arkorobotics/DEMI_Buffer/3D Printables/connector_housing_extended v2.stl

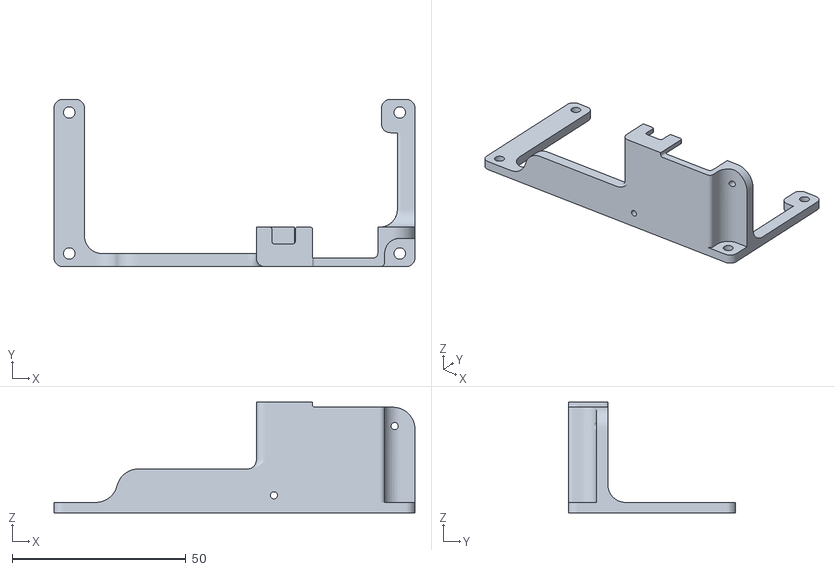
[picture p1: CAD file, 2023-05-14]
3D Printables/connector_housing_extended v2.stl
104.0 x 48.3 x 32.0
