arkorobotics/DEMI_Buffer/DEMI_Buffer.pdf

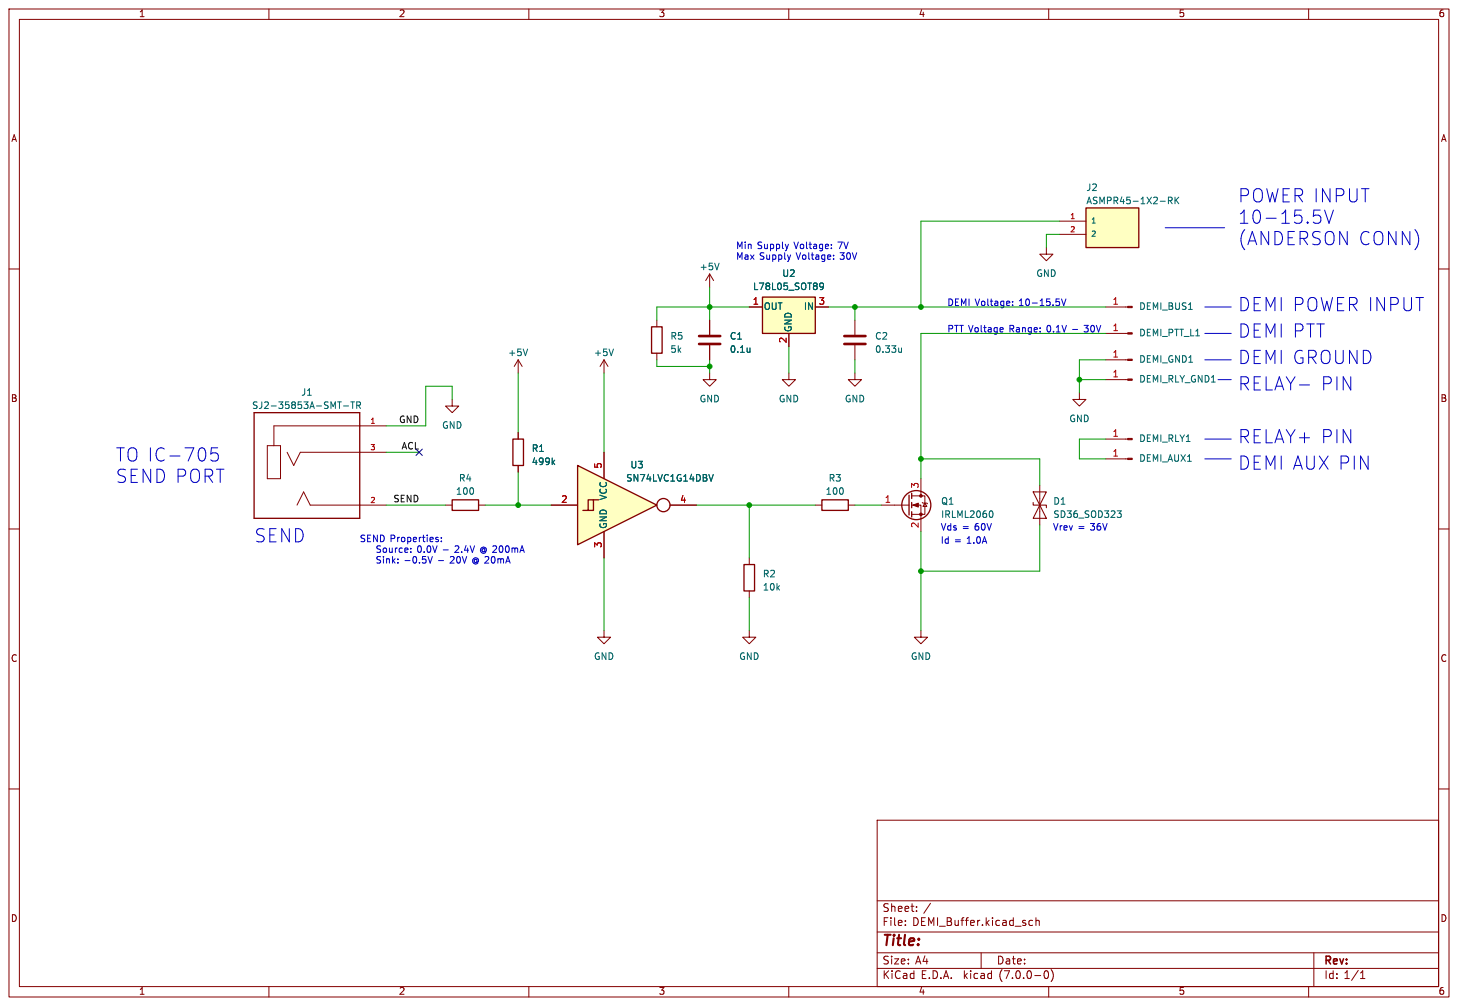
[picture p2: page 1]

Id: 1/1 Title: File: DEMI_Buffer.kicad_sch Sheet: /
