arkorobotics/DEMI_Buffer/DEMI_Buffer.kicad_pcb

## KiCad design DEMI_Buffer.kicad_pcb (2023-05-14)

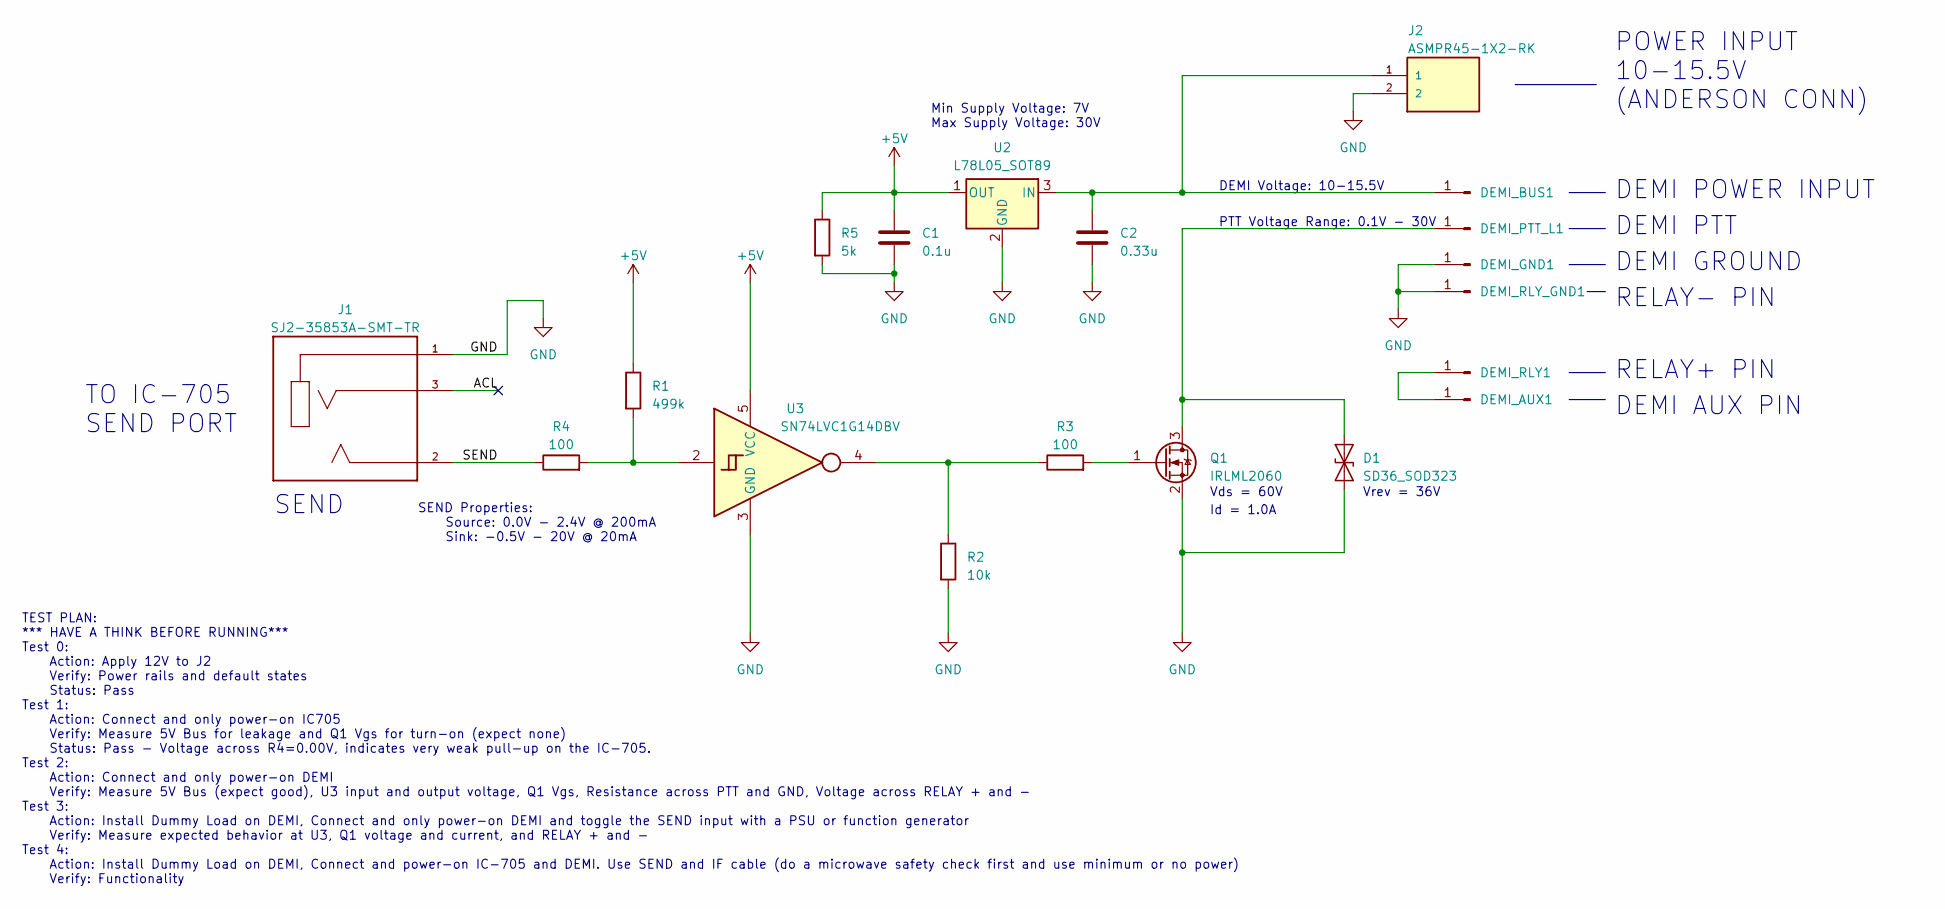
[picture p3: schematic DEMI_Buffer.kicad_sch]

Parts:
C1: 0.1u; C_0603_1608Metric
C2: 0.33u; C_0603_1608Metric
D1: SD36_SOD323; D_SOD-323
DEMI_AUX1: Conn_01x01_Pin; SolderWirePad_1x01_SMD_2.5x5mm
DEMI_BUS1: Conn_01x01_Pin; SolderWirePad_1x01_SMD_3x6mm
DEMI_GND1: Conn_01x01_Pin; SolderWirePad_1x01_SMD_3x6mm
DEMI_PTT_L1: Conn_01x01_Pin; SolderWirePad_1x01_SMD_2.5x5mm
DEMI_RLY1: Conn_01x01_Pin; SolderWirePad_1x01_SMD_2.5x5mm
DEMI_RLY_GND1: Conn_01x01_Pin; SolderWirePad_1x01_SMD_2.5x5mm
J1: SJ2-35853A-SMT-TR; CUI_SJ2-35853A-SMT-TR; MPN SJ2-35853A-SMT-TR
J2: ASMPR45-1X2-RK; APP_ASMPR45-1X2-RK; PARTREV N/A
Q1: IRLML2060; SOT-23
R1: 499k; R_0603_1608Metric
R2: 10k; R_0603_1608Metric
R3, R4: 100; R_0603_1608Metric
R5: 5k; R_0603_1608Metric
U2: L78L05_SOT89; SOT-89-3
U3: SN74LVC1G14DBV; SOT-23-5

Connections:
+5V: C1.1, R1.1, R5.1, U2.1 (OUT), U3.5 (VCC)
/ACL: J1.3
/SEND: J1.2, R4.1
GND: C1.2, C2.2, D1.1 (A1), DEMI_GND1.1, DEMI_RLY_GND1.1, J1.1, J2.2, Q1.2 (S), R2.2, R5.2, U2.2 (GND), U3.3 (GND)
unnamed: D1.2 (A2), DEMI_PTT_L1.1, Q1.3 (D)
unnamed: DEMI_AUX1.1, DEMI_RLY1.1
unnamed: C2.1, DEMI_BUS1.1, J2.1, U2.3 (IN)
unnamed: Q1.1 (G), R3.2
unnamed: R1.2, R4.2, U3.2
unnamed: R2.1, R3.1, U3.4

Notes on the sheet:
PTT Voltage Range: 0.1V - 30V
DEMI PTT
DEMI GROUND
RELAY- PIN
DEMI AUX PIN
SEND
TO IC-705 SEND PORT
RELAY+ PIN
TEST PLAN: *** HAVE A THINK BEFORE RUNNING*** Test 0: Action: Apply 12V to J2 Verify: Power rails and default states Status: Pass Test 1: Action: Connect and only power-on IC705 Verify: Measure 5V Bus for leakage and Q1 Vgs for turn-on (expect none) Status: Pass - Voltage across R4=0.00V, indicates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
DEMI Voltage: 10-15.5V
Id = 1.0A
DEMI POWER INPUT
POWER INPUT 10-15.5V (ANDERSON CONN)
SEND Properties: Source: 0.0V - 2.4V @ 200mA Sink: -0.5V - 20V @ 20mA
Vrev = 36V
Min Supply Voltage: 7V Max Supply Voltage: 30V
Vds = 60V

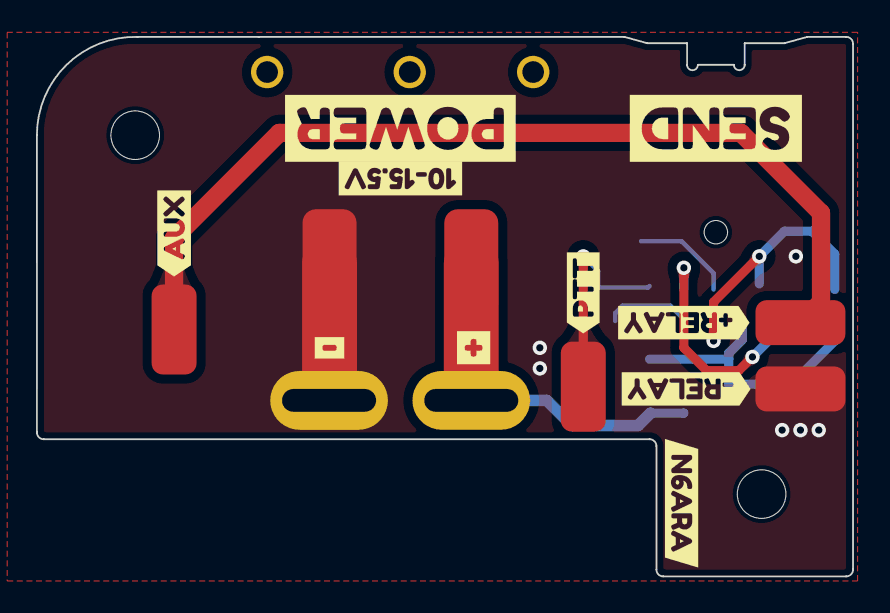
[picture p4: board DEMI_Buffer.kicad_pcb from above]

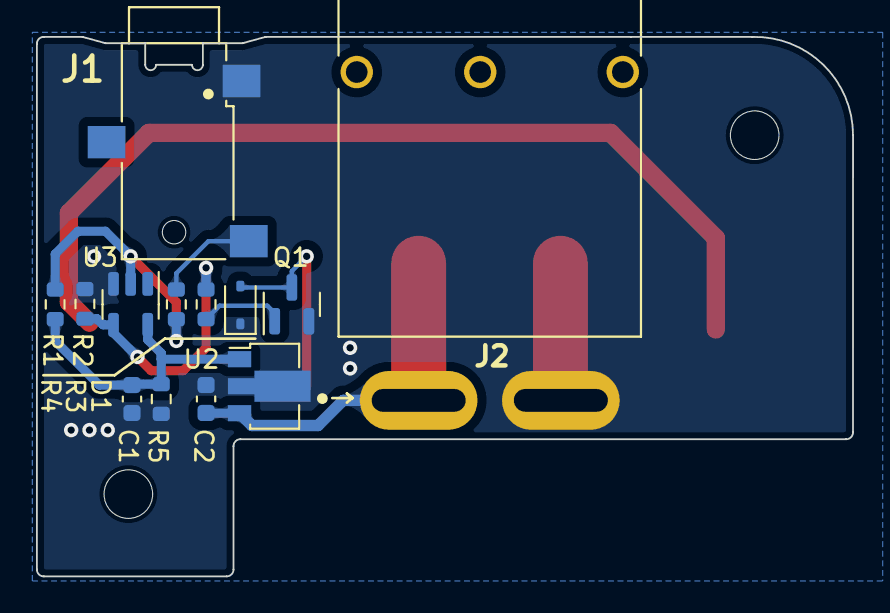
[picture p5: board DEMI_Buffer.kicad_pcb from below]

Board: 2 copper layers, 45.3 x 30.0 mm, 29 parts (13 on the bottom side), 9 nets.

Other parts of the board:
kibuzzard-63FD1EDA: G***; kibuzzard-63FD1EDA
kibuzzard-63FD1EF5: G***; kibuzzard-63FD1EF5
kibuzzard-63FD36AA: G***; kibuzzard-63FD36AA
kibuzzard-63FD37BB: G***; kibuzzard-63FD37BB
kibuzzard-63FD37D3: G***; kibuzzard-63FD37D3
kibuzzard-63FD203D: G***; kibuzzard-63FD203D
kibuzzard-63FD370C: G***; kibuzzard-63FD370C
kibuzzard-63FD371C: G***; kibuzzard-63FD371C
kibuzzard-63FD3696: G***; kibuzzard-63FD3696
kibuzzard-63FD7275: G***; kibuzzard-63FD7275
