arkorobotics/DEMI_Buffer/(commit log)

2023-05-14 Initial Commit
    Initial Commit
    [DEMI_Buffer-B_Cu.gbr, DEMI_Buffer-B_Mask.gbr, DEMI_Buffer-B_Paste.gbr, DEMI_Buffer-B_Silkscreen.gbr, DEMI_Buffer-Edge_Cuts.gbr, DEMI_Buffer-F_Cu.gbr, DEMI_Buffer-F_Mask.gbr, DEMI_Buffer-F_Paste.gbr]
2023-05-27 Cleaned up the repo a bit
    Cleaned up the repo a bit
    [DEMI_Buffer.kicad_sch, connector_housing v10.stl, connector_housing v6.stl, connector_housing v9.stl, connector_housing_extended v2.stl]
